electrickery/ROM-emulator/(threads)

Thread 1 (2022-01-31):

6264 CE pin

Dale-Lien, 2022-01-31:
Hi,
In emuPod schematic, the 6264 pin 24 is A9, not CE, the 6264 only have one CE on pin 26, and have one /CE on pin 20.

electrickery, 2022-01-31:
Hi Dale-Lien,
You are quite right, the files are outdated, the emuPod (for 24 pin devices) does not support the 6264, but the new emuPod28 does. The new files have the pin 24  issue fixed.
The software/firmware is also updated.
Greeting,
Fred Jan

Dale-Lien, 2022-02-01:
Hi electrickery,
Thanks for your answer.

Closed 2022-02-01.
