electrickery/ROM-emulator/KiCAD-files/ROMemu1.3.kicad_pcb.pdf

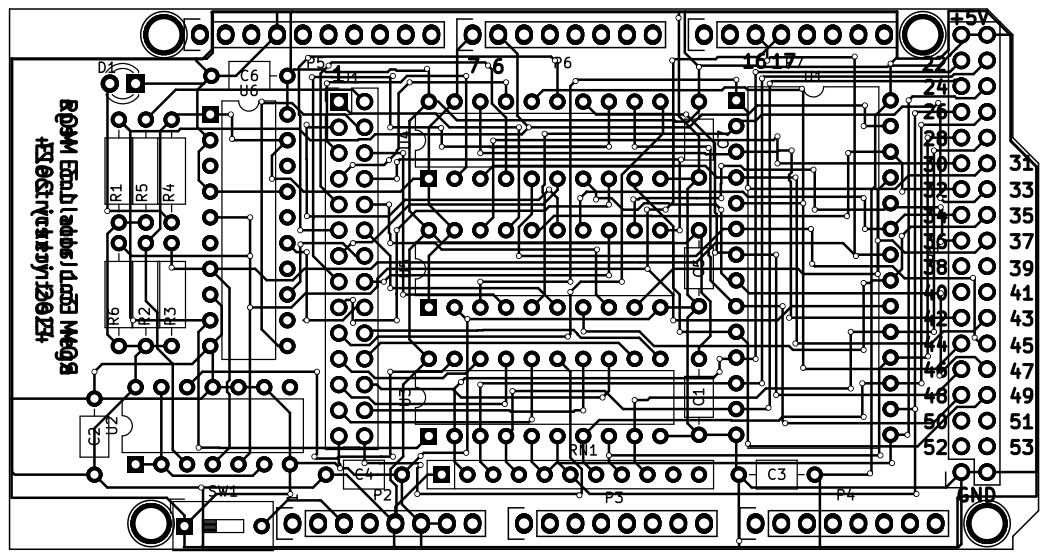
[picture p5: page 1]
