electrickery/ROM-emulator/KiCAD-files/ROMemu1.3.sch.pdf

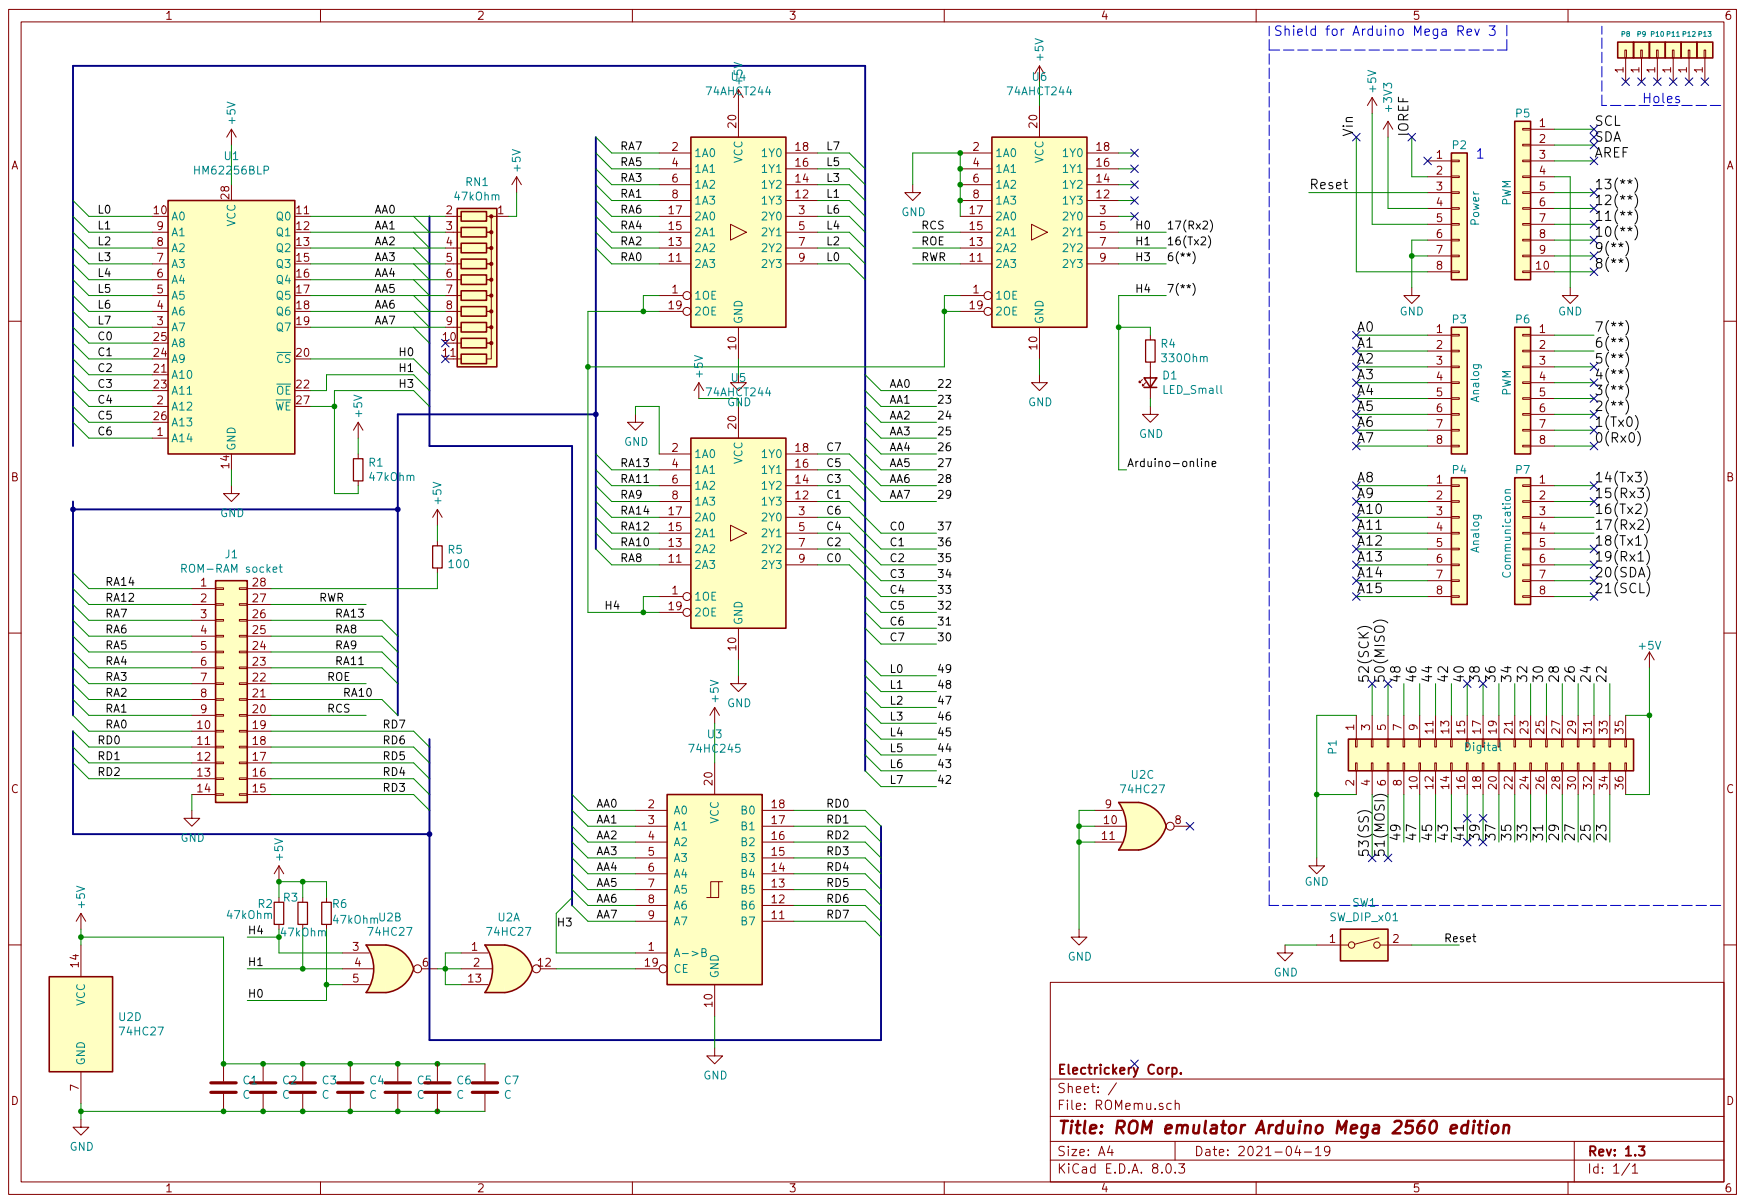
[picture p6: page 1]
