electrickery/ROM-emulator/KiCAD-files/RomEmuV1.2.pdf

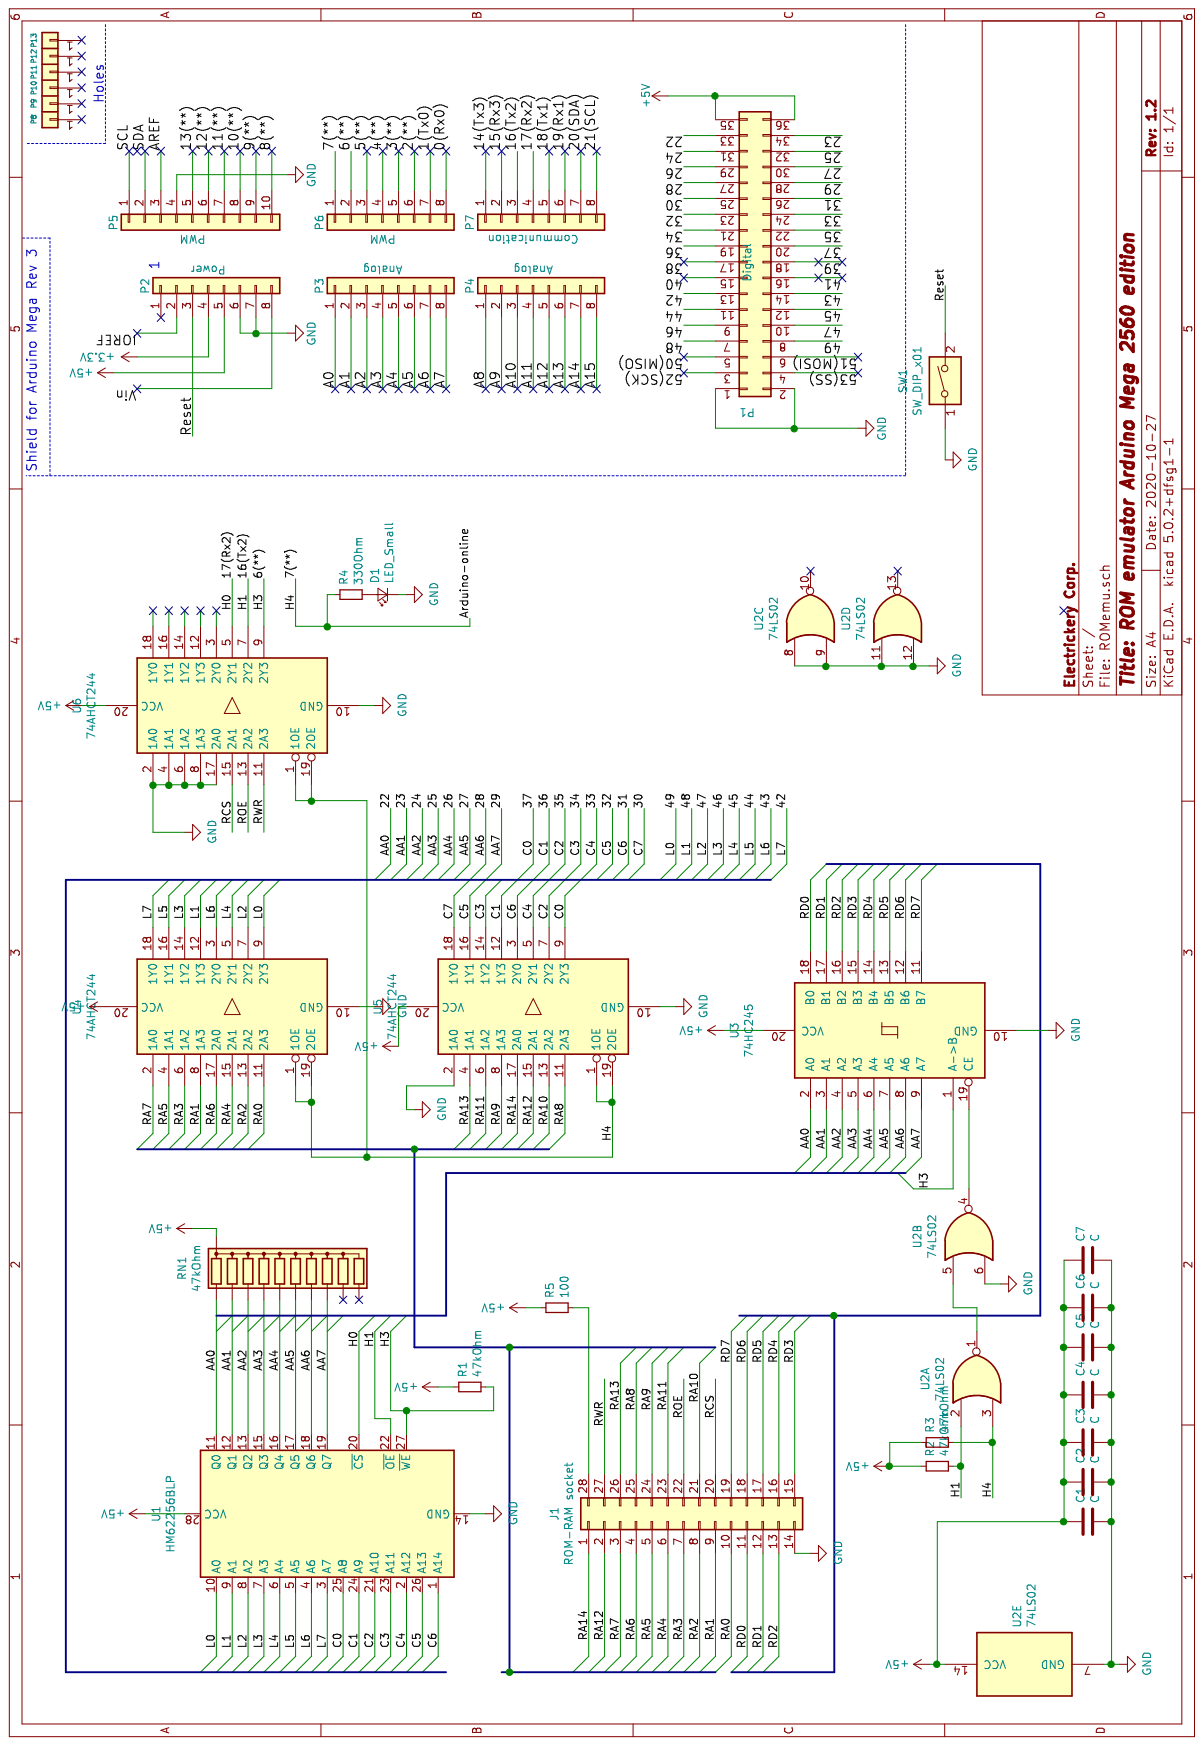
[picture p7: page 1]
