electrickery/ROM-emulator/(commit log)

2023-01-14 Updated structure to be more Arduino-IDE compatible.
2023-01-14 Added missing 28p. socket adapter pcb data.
2024-07-27 New board files and new download tool.
2024-08-01 Added support for RESET relay.
    [ROMemu.ino, romEmuTerminal.py]
2024-10-12 Updated board status.
2025-07-18 Fixed bug in Motorola Exorciser upload.
    [ROMemu.ino]
2025-07-18 Fix in usage/help text.
    [ROMemu.ino]
